Roh00t/SDTH-Killswitch-Demo/video/KILLSWITCH_30s_promotional_pitch.md

# KILLSWITCH — 30-Second Promotional Pitch

> **Final render, submitted 27 September 2026:**
> [`video-demo/killswitch_product_video.mp4`](../video-demo/killswitch_product_video.mp4)
> (42 s, 1280×720). Built from `manim_code.py` and `SDTH_Video.ipynb` in this folder. This
> file is the original brief.

**Format:** Manim motion graphics + AI-generated cinematic footage  
**Tone:** Premium defence-tech launch film; urgent, precise, credible  
**Visual language:** Dark navy/black, cream-white typography, cherry-red threat and engagement graphics  
**Core message:** Air defence should operate as one coordinated network.

It should not look like a slides deck, but like a premium motion graphics video.

---

## Scene 1 - Hook

### Visual

'Killswitch' written out in a serif italic font in the center of the screen in cherry red
A subtitle follows: "Low energy mobile laser air defence network" in cream beige

---

## Scene 2

### Visual
Transition to a stylised top-down city map outline of singapore all generated proceduraly in manim. the city should be borderline must be drawn out.

show a swarm of drones with a red dot flying from the southern coast into city centre following a straight path.
simultaneously show how the count decreases as the drone gets to the city by laser defense nodes located along the coast of singapore. 

Next move it to the side and list out the following bullet points:
- cost effective: <$3 / drone threat
- highly mobile
- virtually infinite magazine

---

## Scene 3

### Visual
AI video demo visualisation. the video is saved as an mp4 file. integrate the video into the manim animation using opencv2 method. 
---

## Scene 4

draw a scale with drone air defense on the left and missile interceptors at the right. then highlight a region in the middle and write laser. then go over the benefits of lasers over drone and missile defense:

**Laser**
- cost effective: <$3 / drone threat
- highly mobile
- virtually infinite magazine
- precise targeting
- rapid engagement

---

## Scene 5
a demo video is saved as an mp4 file. integrate the video into the manim animation using opencv2 method. 

---

## Scene 6
Cut to black.

Same killswitch logo as the first scene.

### Voiceover
> **“KILLSWITCH. One network. Human in command.”**

### Final screen
# **KILLSWITCH**

**ONE NETWORK. HUMAN IN COMMAND.**

*Networked command and control for distributed air defence.*

---

## Production Direction

The video should **not feel like seven PowerPoint slides squeezed into 30 seconds**. Treat it as one continuous visual story. Use Manim for typography, maps, tracks, network topology and UI transitions; use AI-generated footage only for the high-impact physical shots of the drone threat, Singapore environment and mobile directed-energy nodes.

Keep cuts fast during the opening problem, then slow slightly during the KILLSWITCH reveal so the product name lands. The strongest visual sequence should be **Detect → Track → Decide → Authorise → Engage**, because it communicates what the product actually does without requiring a technical explanation.

Avoid trying to explain the underlying laser physics, market size or detailed specifications in this film. The objective of these 30 seconds is to make the judges immediately understand and remember **KILLSWITCH as the coordination layer that turns distributed air-defence assets into a single human-supervised network**.
