Roh00t/SDTH-Killswitch-Demo/report/Killswitch_Report.docx

K I L L S W I T C H

Software-Defined Directed Energy (SDDE)

Reversing the economic death spiral of modern air defence.

Team 49, Killswitch

Singapore Defence Tech Hackathon 2026

Operational Classification: Counter-UAS Targeting & Fire-Control Layer

Primary Track: B, Autonomous Systems & Edge AI (Host Inference, Edge Actuation)

LOTR With Sentinal

1. Executive Summary

Killswitch is an open-architecture, human-in-the-loop targeting and fire-control layer designed to defeat low-cost unmanned aerial systems (UAS) threatening critical urban and sovereign infrastructure. The platform pairs host-based computer-vision inference with edge-microcontroller actuation, enforcing deterministic safety boundaries in firmware to eliminate unauthorised or out-of-envelope directed-energy release.

- Operational challenge: Mass drone swarms break the economics of conventional air defence (~$1M kinetic interceptors against ~$1,000 targets) while creating catastrophic debris hazards over dense populations and petrochemical facilities.
- The Killswitch solution: A distributed, software-defined targeting layer that automates optical acquisition, tracking and aimpoint maintenance, and requires exactly one operator decision to authorise firing, one operator supervising many turrets (1:x), a concept shown with one physical node and simulated map markers.
- Strategic impact (hardened baseline): Verified deterministic fail-safes, a 254 ms deadman cutoff and a 2002 ms maximum burn ceiling, enforced in microcontroller firmware. The system achieves 1.2 px tracking error against static targets and 3–6 px against linear crossing targets.
- Concept economics (from our thermal model): A low-power (~5 kW) commercial laser reaches melt onset on a small UAV at ~1.11 s at 350 m in our own thermal model (tools/thermal_sim.py), at an energy cost of cents of electricity per engagement.it preserves finite kinetic interceptors for the threats that require them. Melt onset is not a structural kill.

# 2. Problem Statement & Operational Context

## The Threat Vignette

Twelve launch sites release roughly 100 fibre-optic drones from a container yard in international waters. Carrying no RF link to detect or jam, and a small radar cross-section, they converge on Jurong Island, Changi and the data-centre corridor. There is no single vessel to sink and no one system to intercept, the threat is everywhere at once, warning is measured in minutes, and if the primary drone defence fails, other options must already be in place.

## Why Conventional Air Defence Fails Here

- Cost & magazine depth: Kinetic interceptors deplete rapidly against saturation salvos (a 20-drone swarm at ~$1k each versus $1M-plus per interceptor), leaving high-value assets exposed during protracted engagements.
- Collateral hazards: Kinetic intercepts over dense urban areas or petrochemical facilities such as Jurong Island present unacceptable explosion and shrapnel risk.
- Manpower ceiling: Fifty kilometres of depth and minutes of warning, with too few soldiers to place one operator behind every weapon, the system needs a scalable decision layer, not more people.
- Accountability: When a machine fires, legal responsibility must rest with a human. Machine-speed defence with a human in the loop is a necessity, not a feature.

The economic asymmetry, at a glance:

| Kinetic Missile | Attacker's Drones | KILLSWITCH Laser Node
Range | long, > 50 km | 10–20 km+ (fibre-optic) | ~350 m (modelled)
Speed | > 100 km/h | slow | speed of light
Magazine | low, finite | high, cheap | unlimited (energy-bound)
Exchange | 1 : 1 | — | 1 : many

## Strategic Weather Imposition

Rather than treat tropical rain as a fatal limitation, an operating doctrine (concept, untested) turns it into an imposed asymmetry: an active directed-energy shield in clear and moderate weather forces an adversary to launch only during heavy monsoons, where degraded battery efficiency, blinded optical-flow sensors, disrupted RF links and wind shear make small UAS fight the environment before they reach the objective. This is an untested operating concept; Singapore’s humidity and haze degrade the beam even without rain.

# 3. Solution Architecture & Technical Innovation

Architecture principle: Host Inference, Edge Actuation. Deep-learning inference runs on a host laptop; real-time motion control and hardware interlocks execute at the edge on an ESP32-S3, which is the safety authority whose interlocks the host cannot override.

## Signal Chain

- ① Sensor: OV5640 Wi-Fi camera, 640×480 (VGA) MJPG stream; OV5640 capture time NOT MEASURED (an earlier USB-webcam bench measured ~32 ms), plus a 100–200 ms network hop.
- ② Host, Vision & Tracking: YOLO11s ONNX inference (1024×1024), latency-compensated aimpoint calculation (<3 ms), serial TX (CH343 @ 921600 baud, XOR checksum).
- ③ Edge, ESP32-S3 (N16R8): Hardware interlocks (254 ms deadman / 2002 ms burn ceiling), open-loop pan/tilt servo PWM @ 50 Hz (the loop closes visually on the host, ~4.6 fps), effector proxy (KY-008 low-power visible laser, ~5 mW Class 3R, low-side switch).
- ④ Operator & C4I: Mandatory SPACE authorisation window (10 s); outbound CoT XML over UDP multicast to ATAK-Civ.

## Engagement State Machine

- 1. SCAN, Calibrated step-and-stare search (20° steps, 0.5 s settle, 2 looks per stop).
- 2. DETECT, YOLO registers a target label; unrecognised or drifted labels are dropped at the input stage.
- 3. TRACK, Pan/tilt slews to align boresight; the control law steps only on new frame_id updates to eliminate stale-observation windup.
- 4. HOLD, Target held within a 15 px (~1.5°) band for 3.0 continuous seconds.
- 5. OPERATOR_AUTH, Armed pause with a 10 s countdown; the operator presses SPACE to authorise or D to deny.
- 6. ENGAGE, Effector fires for exactly 1.8 s (inside the 2002 ms firmware ceiling), then auto-shuts and returns to IDLE.

# 4. Technical Validation & Engineering Hardening

## Evidentiary Discipline

Every figure below carries an explicit evidentiary tag: MEASURED (observed on the rig or in the simulation suite), DERIVED (computed from measured stages), DESIGN (architectural limit), ESTIMATE, and NOT MEASURED. Detection accuracy is deliberately withheld rather than asserted from an unverified run.

Quantitative Performance Matrix

Subsystem / Metric | Value | Status | Source / Verification
Optical Capture (USB webcam, superseded) | ~32 ms (16.7 ms exposure + 15 ms driver) | MEASURED | Earlier USB-webcam bench, not the current OV5640
YOLO11s Inference (1024×1024) | 216 ms/frame (4.6 fps) | MEASURED | macOS CPU, best.onnx (demo runs COCO on Windows)
Track + Aimpoint Calculation | < 3 ms | ESTIMATE | Architectural timing limit
Serial TX + ESP32 Parsing | ~3 ms (921600 baud) | ESTIMATE | Serial protocol calculation
Total Latency (Direct USB) | ≈ 254 ms | DERIVED | Sum over the superseded USB-webcam path
Wi-Fi Camera Network Hop | +100 to 200 ms | ESTIMATE | Network transit estimate
Total Sensor-to-Effector Latency | ≈ 414–514 ms (incl. 60 ms servo slew) | DERIVED | Full-pipeline baseline over Wi-Fi
Tracking Error (Static Target) | 1.2 px | MEASURED | Closed-loop simulation (1280 px, not the 640 px rig)
Tracking Error (Crossing Target) | 3–6 px (at 5°–20°/s) | MEASURED | Closed-loop simulation (1280 px, not the 640 px rig)
Dynamic Tracking Limit | Fails at ±15° weave @ 0.2 Hz (21.7 px) | MEASURED | Closed-loop sim · loop-bandwidth limit, 4.6 fps
HOLD Alignment Band | 15 px ≈ 1.5° (~8 cm at 3 m) | DERIVED | Optical geometry (FOV uncalibrated, see bench.yaml)
Hardware Deadman Timeout | 254 ms (250 ms design) | MEASURED | Firmware timer, physical ESP32 (v2 bench; re-verify on v3)
Hardware Burn Cutoff | 2002 ms (2000 ms design) | MEASURED | Firmware timer, physical ESP32 (v2 bench; re-verify on v3)
Firmware Application Size | 1,049,558 / 3,145,728 B (33.4%) | MEASURED | Build output report
Software Test Suite | 337 tests passing | MEASURED | pytest tests/ -q (offline)
Hardware Interlock Suite | 13 / 13 passed | MEASURED | Physical, firmware v3 (interlock state; laser wiring re-verify)
Detection Precision / Recall / mAP | Pending held-out evaluation | NOT MEASURED | Explicitly withheld from claims

Note: Tracking-error figures (static, crossing, dynamic limit) are from the closed-loop simulation suite, not physical live-fire; the Source column states this for each. Deadman and burn-ceiling timings were measured on the physical ESP32 with firmware v2 on the old pins; re-verification on v3 with the laser correctly wired is pending. The 720p / 32 ms optical figure is from a superseded USB webcam, the current OV5640 streams VGA and its capture time is not yet measured.

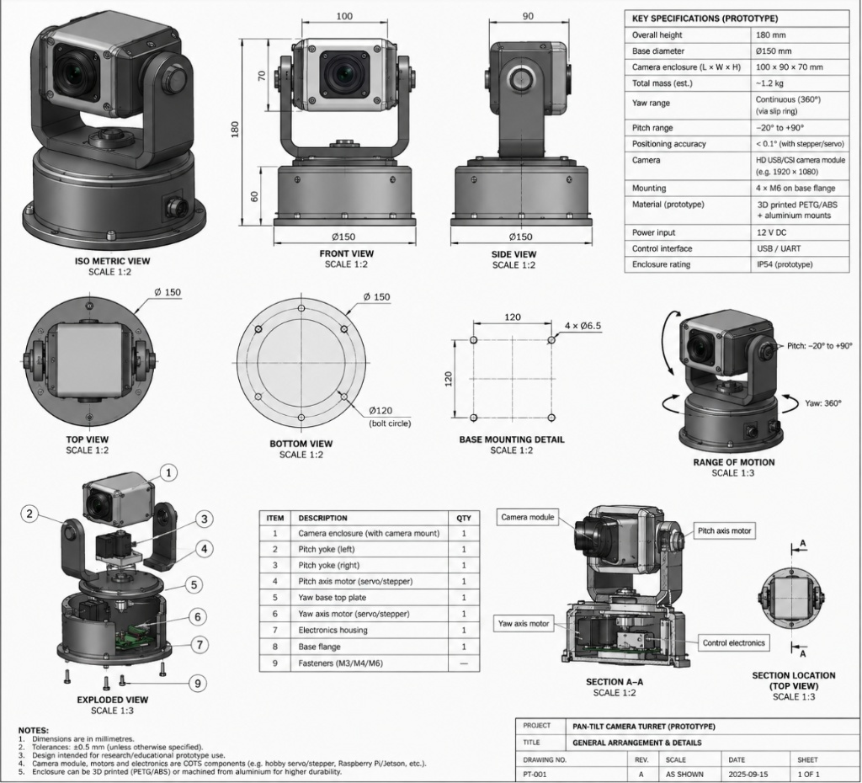
[picture p2: figure]

Figure 1: Concept render of the Phase-2 production turret (concept only, no CAD files yet). The benchtop demonstrator validates the closed-loop control mathematics on a COTS 2-axis mount; this baseline specifies the hardened mechanical path, NEMA 17 steppers, continuous 360° slip ring, and an integrated sealed optical compartment (IP54).

## Real Sprint Hurdles Overcome

- 1. Frame-rate bottleneck (4.6 fps on CPU), At 4.6 fps, weaves above 0.1 Hz broke the 15 px HOLD band, a loop-bandwidth limit set by the 4.6 fps observation rate that no smoothing could overcome. Documented as a sampling constraint; Phase 2 migrates to GPU/NPU or 640 px re-exports for ≥15 fps.
- 2. Stale-observation windup, The 100 Hz control loop re-applied identical pixel errors ~20× per visual frame, saturating actuator commands. Hardened main.py to step strictly on an incremented frame_id.
- 3. Scan-sweep image smear, Continuous scanning at 400°/s blurred frames and prevented inference locks. Replaced with step-and-stare (20° steps, 0.5 s settle, 2 looks).
- 4. Hardware pin collision (GPIO 7), On the ESP32-S3-EYE layout, GPIO 7 carries the camera HREF signal, wiring the laser gate there pulsed the effector at line rate. Relocated actuator pins to Pan 14 / Tilt 21 / Laser 1, with static_assert compile-time overlap checks.
- 5. Wi-Fi camera pipeline recovery, The OV5640 stalled indefinitely on dropped frames. Firmware resets the camera bus after 3.0 s of frame silence; the host reader auto-reconnects.
- 6. Input / serialisation hazards, Non-finite floats (Infinity, NaN) from a neutralised threat’s infinite time-to-impact froze the dashboard. All outbound telemetry now passes a strict dashboard_json sanitiser; stale operator authorisations are discarded when the authorisation window opens.

# 5. Military Integration & Strategic Scaling

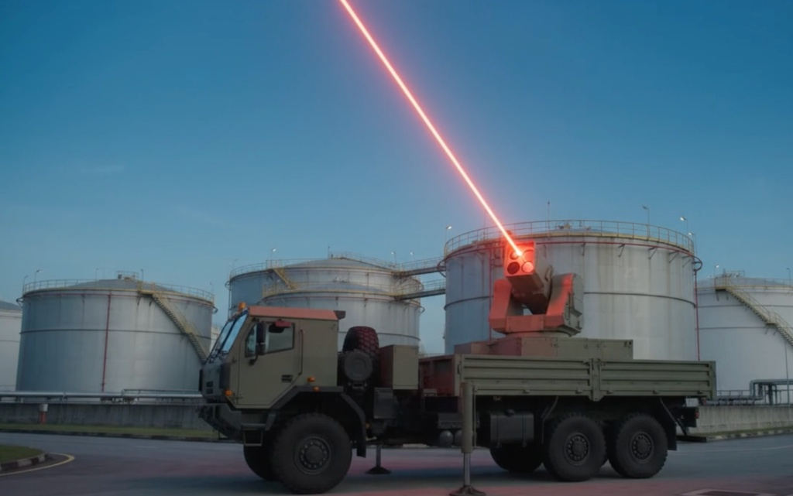
[picture p3: figure]

Figure 2: Operational deployment concept for mobile infrastructure point-defence. Killswitch targeting nodes on tactical transport platforms provide mobile, low-collateral defensive screens for high-value petrochemical and military installations.

## Track A, Input Integrity & Effector Isolation

Killswitch is built on an effector-isolation model. The prototype MQTT transport is plaintext on port 1883 with a shared token; the architecture isolates the effector regardless:

- Zero unauthenticated control: external WebSockets and network feeds have no direct write path to the actuator; commands originate only from the host engine loop.
- Track-locked authorisation: a token issued for Track A cannot execute if the system switches to Track B.
- Fail-safe parsing: malformed frames, out-of-range values or checksum mismatches drive the laser output LOW and return an error state.
- Hardware isolation window: on host OS freeze, kernel panic or disconnection, the ESP32 deadman cuts laser power within 254 ms.

## Track C, C4I & Tactical Decision Support (ATAK-Civ)

- Operator cognitive management: exactly one human decision per engagement, the operator evaluates track context, confirms the backstop is clear, and presses SPACE; they never aim or slew the system.
- Map honesty: outbound CoT feeds to ATAK-Civ mark simulated swarm entities with a SIMULATED tag; only Node 1 reports physical telemetry, preventing a false operational picture during hybrid exercises.
- Tasking independence: operator keys 1–3 append tasking metadata to simulated tracks only; they hold no authority to command or fire a physical effector.

# 6. Lifecycle Roadmap & Phase-2 Maturation

Domain | Milestones & Engineering Deliverables
Host Inference | Port the model to a dedicated GPU/NPU (≥15 fps target); formal evaluation on a held-out dataset for empirically verified mAP50, precision and recall.
Physical Actuation | Replace hobby servos with brushless motors and optical absolute encoders; add integrated hardware timestamps to measure and compensate for Wi-Fi transit jitter.
Cyber Hardening | Migrate MQTT to mTLS 1.3 (port 8883); HMAC-SHA256 serial-frame validation; ESP32-S3 Secure Boot v2 and Flash Encryption.
Operational Safety | CAAS-compliant live-fly testing with a certified Range Safety Officer; transition from the proxy diode to a rated effector behind identical firmware safety gates.

Killswitch delivers a sovereign, mathematically grounded targeting layer that restores defensive cost dominance in dense urban theatres, an auditable, scalable C-UAS fire-control solution with a human always in the loop.

THE ASK

We proved the mathematics that don't change with scale. Incubation unlocks the conditions a lab cannot create.

What we proved, on ~$200 of COTS hardware

- The full loop in simulation: detect → track → predict → hold → authorise → engage. On hardware, actuation and firmware interlocks are verified; live detection is pending.
- Firmware-enforced safety, measured on the physical board (firmware v2 bench; re-verification on v3 pending): 254 ms deadman cutoff, 2002 ms burn ceiling. The human gate is a state in the transition table, not a callback anyone can forget.
- Sub-degree tracking in simulation (1280 px, not the rig): 1.2 px against static targets, 3–6 px against crossing targets.
- 337 automated tests passing; 13/13 firmware-interlock checks (interlock state proven; laser wiring re-verify).
- We report only what we measured, detection accuracy is withheld, not inflated.

What only you can unlock, beyond any lab or hackathon

- Live-fly range time with a Range Safety Officer, CAAS-compliant testing against real airborne targets, not simulation.
- A rated effector behind our identical firmware safety gates. We fire a low-power visible laser proxy (<5 mW, Class 3R) today; the firmware safety logic is designed for a hazardous emitter, a fielded HEL also needs beam-path interlocks and key control we have not built.
- Harsh-condition validation, tropical humidity, haze, monsoon rain and thermal blooming: the exact envelope our weather doctrine rests on, that no bench reproduces.
- Threat-representative targets, fibre-optic and fixed-wing drones we cannot legally acquire or fly on our own.
- A compute path to ≥15 fps (GPU/NPU) to clear the 4.6 fps sampling bottleneck we have already documented.

What you get

For the incubator (NUS Defence Venture Lab and programme partners)

- A dual-use, software-defined venture with a defensible wedge, the portable targeting brain, not another turret.
- A working prototype and honest metrics already in hand, from a team that demonstrably ships.
- A sovereign-capability story aligned to your national mandate, and a stake in a layer that re-hosts across many effectors.

For the defence stakeholder (MINDEF · DSTA · RSAF)

- A cost-exchange fix you own, not one you license from a foreign prime.
- Sovereign, auditable, human-gated software: every engagement logged, no black box.
- Hardware-agnostic, it augments existing kinetic and future directed-energy assets, protecting prior investment.
- A low-risk way to evaluate the 1:x operator-ratio concept before committing to a programme of record.

ONE NETWORK. MULTIPLE NODES. HUMAN CONTROL.

KILLSWITCH · Team 49 · SDTH 2026 Page 1 of 2
