Roh00t/SDTH-Killswitch-Demo/Pitch_Deck_KILLSWITCH.pdf

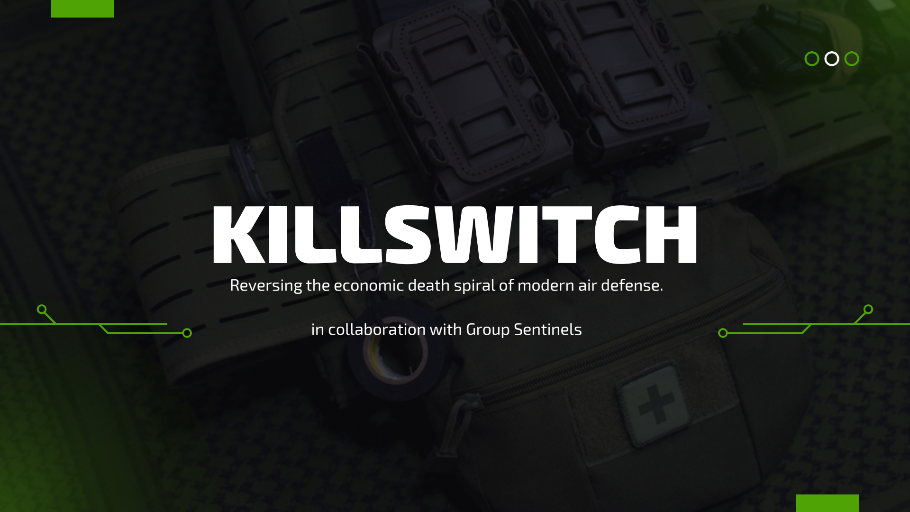
[picture p4: page 1]

KReve

I

rsinLg the eLconomSic deaWth spiral of

I

modTern airCdefenHse.

in collaboration with Group Sentinels

## SCENARIO

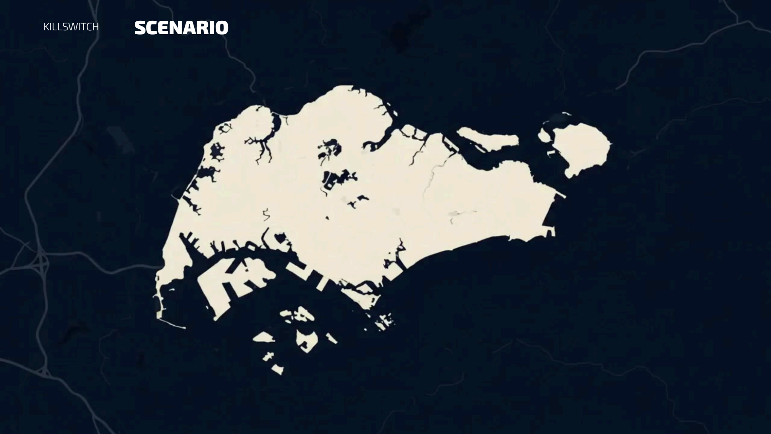
[picture p5: page 2]

KILLSWITCH

# AIR DEFENSE TODAY

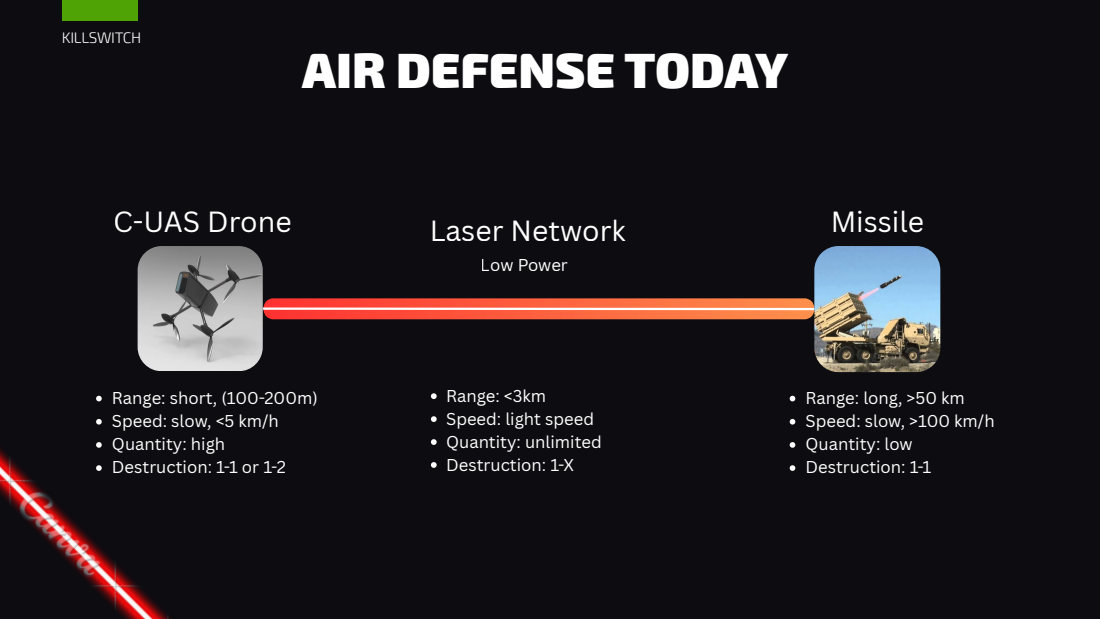
[picture p6: page 3]
Range: short, (100-200m) Speed: slow,; <5 km/h Quantity: high Destruction: 1-1 or 1-2; C-UAS Drone; Missile; Range: long,; Speed: slow,; >100 km/h Quantity: low Destruction: 1-1; Laser Network; Low Power

Range: <3km
Speed: light speed
Quantity: unlimited
Destruction: 1-X

# THE PROBLEM

1.The Cost Disparity: Defense forces are firing $3,000,000 kinetic interceptors to shoot down $2,000 commercial fiber-optic drones.

Modern militaries are bankrupting themselves to defend against cheap technology.

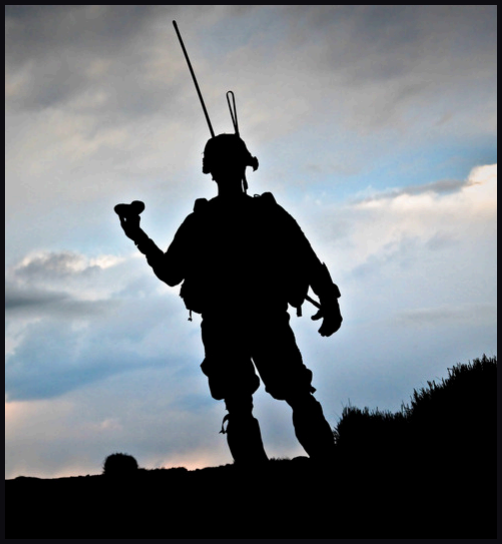
[picture p7: figure]

3.The Magazine Depth Flaw: Swarms do not present a single point of failure. Current air defense systems rely on a finite number of missile tubes; once the magazine is empty, the airspace is completely defenseless.

2.The Human Bottleneck: Traditional systems require a 1:1 operator-to-weapon ratio. When facing a 40-drone swarm, a 1:1 human decision cycle is mathematically too slow to prevent perimeter breaches.

# THE SOLUTION

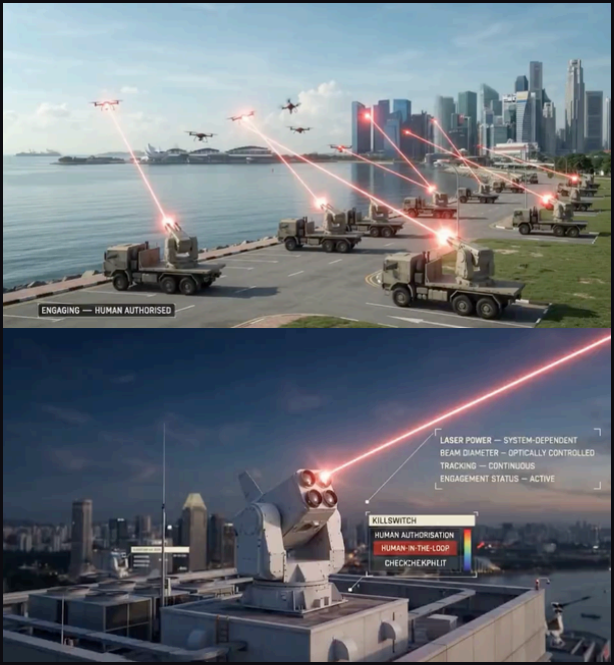
[picture p8: figure]

1.Imbalance Over Vaporization: Legacy military lasers (50kW+) require massive diesel generators just to melt metal.

KILLSWITCH utilizes low-cost, low-power (5kW) commercial lasers to apply steady thermal load to aerodynamic weak points (rotors, polymer struts). At high RPMs, a mere 5% structural deformation causes catastrophic aerodynamic imbalance, tearing the drone apart in mid-air.

2. 1:10 Decision Layer: Partnering with Team Sentinels, our software architecture eliminates the 1:1 manpower bottleneck, allowing a handful of operators to run the entire grid.

3.Human-in-the-Loop (HITL): The network automatically detects, tracks, and assigns the optimal overlapping lasers to the target. The machine handles the micro-millimeter tracking; the human operator retains ultimate firing authority, strictly satisfying military Rules of Engagement (ROE).

# SIMULATION

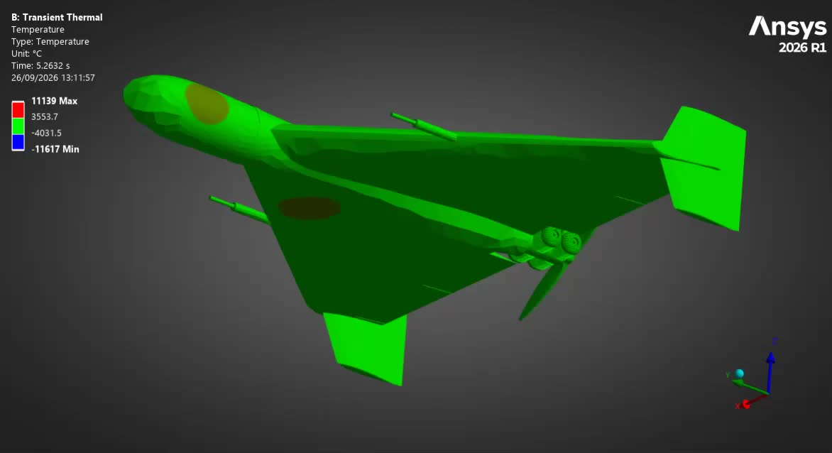
[picture p9: figure]

### COST EFFECTIVENESS:

Works alongside kinetic
interceptors
5 KW turrets thermally degrades a singular small UAV in 1.7s

<$1 / node : <$3 to take down a drone

Threat: 100 simulated Shahed-class microdrones inbound at 50 m/s (180 km/h).
Convergence Math: 1 Laser = Baseline TTK. 2 Lasers = 50% TTK. 4 Lasers = Instant structural failure.
Result: Multi-node simultaneous engagement clears the swarm before perimeter breach.

# HOW IT WORKS

A self-scaling, distributed defensive web that multiplies lethality through overlapping sectors.

Imbalance Kill: Thermal load warps the composite propeller. At high RPMs, the aerodynamic

Detect: LiDAR acquires the target at a 3 km range.

Classify: Edge AI identifies the drone type and maps its specific structural weak points (e

Deconflict: The AI algorithm calculates safe firing trajectories to ensure zero collateral

Converge: Multiple networked lasers are assigned to overlap on the exac

# Add a subheading

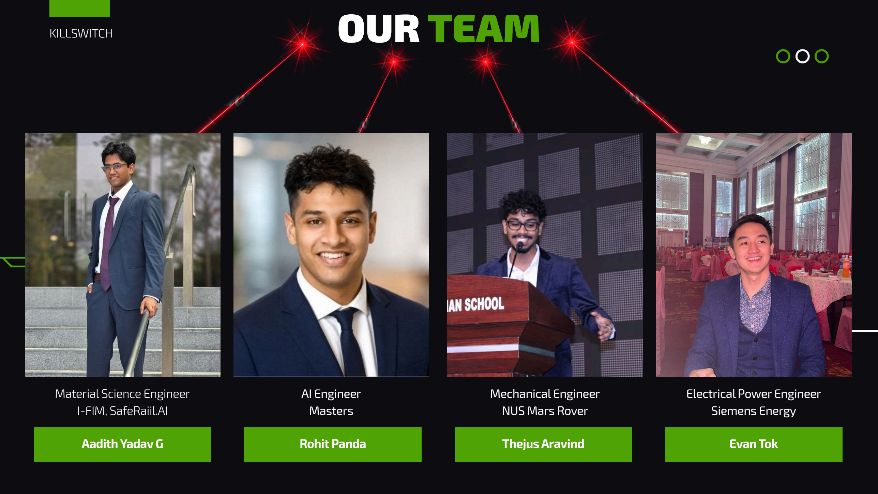
[picture p10: page 8]

AadithYadavG | Rohit Panda | ThejusAravind | Evan Tok
KILLSWITCH | OUR TEAM

Material Science Engineer
I-FIM, SafeRaiil.AI

AI Engineer
Masters

Mechanical Engineer
NUS Mars Rover

Electrical Power Engineer
Siemens Energy
