Roh00t/SDTH-Killswitch-Demo/video/aadith.jpg

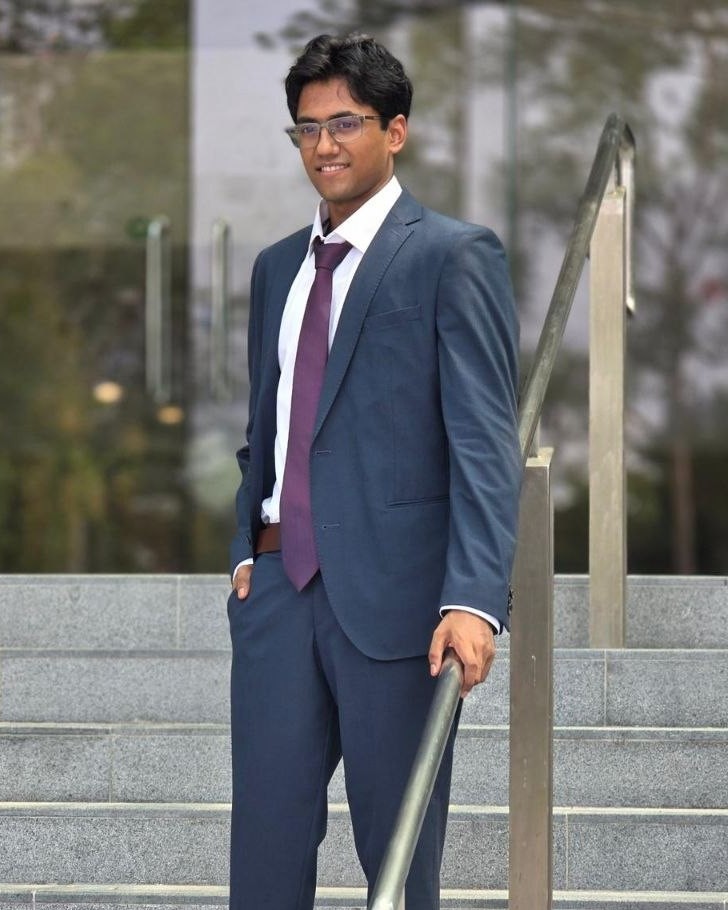
video/aadith.jpg
