Roh00t/SDTH-Killswitch-Demo/video/evan.jpg

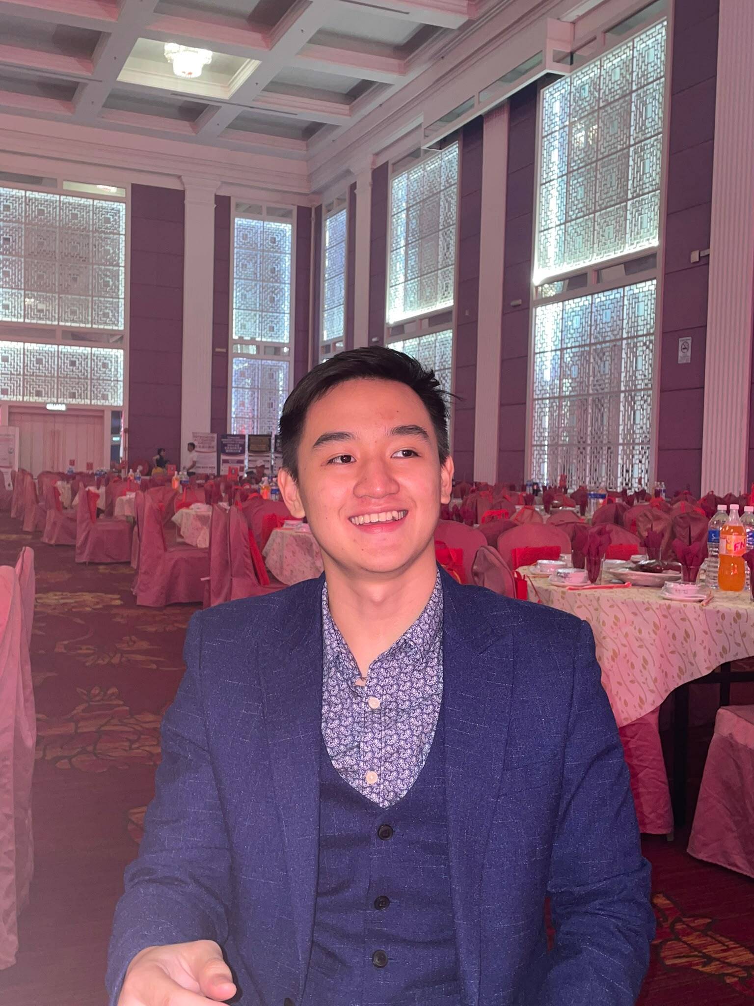
video/evan.jpg
