Roh00t/SDTH-Killswitch-Demo/video/rohit.jpg

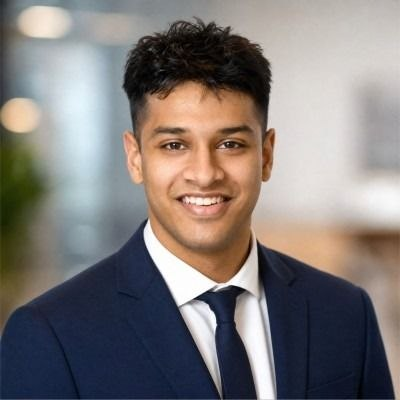
video/rohit.jpg
