Roh00t/SDTH-Killswitch-Demo/video/thejus.jpg

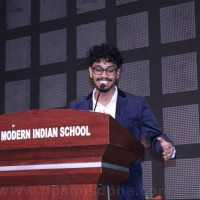
video/thejus.jpg
