Roh00t/SDTH-Killswitch-Demo/config/bench.yaml

# Killswitch — benchtop node configuration.
# Every tunable lives here. No magic numbers in code (CLAUDE.md coding standards).

node:
  id: "killswitch-01"
  tick_hz: 100          # State machine tick. Fast: it enforces every fail-safe.

camera:
  device_index: 0
  width: 1280
  height: 720
  target_fps: 60
  use_mjpg: true
  # Horizontal field of view, degrees. CALIBRATE THIS: point at a known angular
  # span and measure. It sets the pixel-to-degree gain for the whole control
  # loop, so an error here shows up as sluggish or oscillatory tracking.
  horizontal_fov_deg: 65.0
  # ESP32-S3 Wi-Fi camera. When set, it is used INSTEAD of device_index.
  # The firmware prints it on COM3 once Wi-Fi is up ("CAM http://.../stream"),
  # and main.py logs it. null = use the USB camera at device_index.
  # With the OV5640, re-measure horizontal_fov_deg above for that lens.
  stream_url: "http://10.244.153.41/stream"
  # If the gimbal turns AWAY from the target, flip that axis (stream only):
  # pan wrong -> flip_horizontal, tilt wrong -> flip_vertical.
  flip_horizontal: false
  flip_vertical: false

detector:
  weights: "model/best.onnx"
  conf_threshold: 0.40
  iou_threshold: 0.50
  # MUST match the export. best.onnx is a FIXED-SHAPE export at 1024x1024
  # (dynamic=False), so Ultralytics silently ignores any other value. Setting
  # 640 here does not make it run at 640 — it makes the config a lie.
  # Verified: onnxruntime reports input "images" shape [1, 3, 1024, 1024].
  imgsz: 1024
  # Model class map, read from ONNX metadata:
  #   {0: drone, 1: bird, 2: airplane, 3: helicopter}
  # bird/airplane/helicopter are the confuser classes — trained as negatives,
  # never engaged. Filtering is by NAME, so index drift cannot silently
  # re-target us; an unknown name is rejected at construction.
  target_classes: ["drone"]
  device: null          # null = let ultralytics choose (cuda > mps > cpu)

targeting:
  # Normalised offset within the detected box.
  #   ( 0.00,  0.00) centre of mass
  #   (-0.35, -0.35) forward rotor hub
  #   ( 0.00,  0.40) slung payload
  offset_x: 0.0
  offset_y: 0.0
  # Below this box dimension the offset is inside box jitter, so the solver
  # reverts to centre-of-mass and says so.
  min_box_px: 40.0

control:
  proportional_gain: 0.6     # Under-damped above ~1.0 on SG90s.
  max_step_deg: 6.0          # Per tick, per axis. Firmware also rate-limits.
  deadband_px: 3.0           # Below this, do not command — SG90s just buzz.

prediction:
  smoothing: 0.4
  max_lead_px: 250.0
  # Seed only; replaced by live measurement within a few frames.
  initial_compute_latency_s: 0.060
  # Servo travel allowance. NOT measurable — SG90s have no position feedback.
  # Estimated, and labelled as estimated wherever it surfaces.
  mechanical_allowance_s: 0.060

engagement:
  hold_error_px: 15.0        # Error band for HOLD.
  hold_duration_s: 3.0       # Continuous. Resets on any excursion.
  track_loss_timeout_s: 1.0  # No target for this long -> back to SCAN.
  scan_timeout_s: 30.0       # No detection for this long -> IDLE.
  auth_timeout_s: 10.0       # No operator decision -> back to TRACK.
  # 1.8, NOT 2.0. The firmware ceiling is MAX_BURN_MS = 2000 and its clock
  # starts when it parses L1, before the host's does — at 2.0 the firmware wins
  # every nominal burn and logs a clean engagement as an "E06 burn ceiling"
  # safety trip. 200 ms of margin gives nominal completion back to the host.
  burn_duration_s: 1.8

scan:
  # One stop per step: with a ~65 deg camera, 20 deg steps overlap each view
  # by about two thirds. 4 deg made sense only while the sweep never stopped.
  pan_step_deg: 20.0
  tilt_step_deg: 20.0
  # Step-and-stare. After each move the gimbal holds still until this many
  # frames, captured at least settle_s after the move, have been through the
  # detector. settle_s covers servo travel plus the Wi-Fi camera's delay
  # (~100-200 ms); a frame sooner than that can show the old view or smear.
  settle_s: 0.5
  looks_per_stop: 2
  max_cycles: 2
  # Azimuth the gimbal faces at pan centre. Cues outside +/-70 of this are
  # rejected, not clamped.
  boresight_azimuth_deg: 0.0

actuator:
  # "auto" finds the USB-UART bridge by description. macOS hands out
  # /dev/cu.usbserial-<n> where <n> changes between plugs, so hardcoding it
  # guarantees a failure at the worst possible moment. Override with an
  # explicit path only if two boards are attached.
  port: "auto"
  baud: 921600
  # Link bring-up budget. Opening the port asserts DTR, which RESETS the ESP32;
  # both waits below happen on every connect, so the real budget is their sum.
  #
  # The ESP32-S3-N16R8 boots slower than the WROOM-1 these were first tuned on
  # (8 MB PSRAM init), and the old 2.0 + 3.0 sat close enough to its real boot
  # time that connect() succeeded or failed by luck. If you still see
  # "No status from firmware ... within", raise connect_timeout_s — never
  # suppress the DTR reset. The reset is what makes "connected" mean "known
  # state", and it is what emits the boot banner reporting PWM attach failures.
  boot_settle_s: 2.0
  connect_timeout_s: 6.0
  stow_pan_deg: 90.0
  stow_tilt_deg: 90.0
  # The rig's pan SG90 turns ANTICLOCKWISE (seen from above) as its angle rises;
  # the cue geometry, the dashboard radar and the control law all mean
  # CLOCKWISE. true mirrors pan in the serial driver, both ways, so the laptop
  # fixes it and the firmware is untouched. serial_probe reads this key too.
  # After changing it, redo the target tape mark: pan 45 points the other way.
  pan_reversed: true

c2:
  broker_host: "localhost"
  broker_port: 1883
  # Shared secret on operator auth. null disables token checking, which is
  # acceptable ONLY on an isolated demo network and must be stated as such.
  auth_token: "sdth-demo-token"

# Annotated video link to tools/operator_console.py. The node owns the camera,
# so the console cannot open it — two processes cannot share a USB device.
video:
  enabled: true
  fps: 15
  max_width: 640
  quality: 60
