Roh00t/SDTH-Killswitch-Demo/firmware/esp32_actuator/wifi_secrets.example.h

// Copy this file to wifi_secrets.h in the same folder and fill it in.
// wifi_secrets.h is gitignored: never commit a real password.
//
// Use the network the laptop is on (e.g. the phone hotspot). The ESP32-S3 only
// does 2.4 GHz: on an iPhone hotspot turn on "Maximise Compatibility".
#pragma once
#define WIFI_SSID     "your-hotspot-name"
#define WIFI_PASSWORD "your-hotspot-password"
