Roh00t/SDTH-Killswitch-Demo/(commit log)

2026-09-20 Step B (ESP32 firmware + SerialActuator + MQTT)
2026-09-20 The model runs on your laptop, the laptop computes the aim angles, and the ESP32 drives the two servos toward the target
2026-09-23 Thermal Kill-Chain Simulation
2026-09-23 INFO: Effective Spot Radius at 350.0m: 43.00 cm INFO: Surface Heat Flux: 1.11 W/cm^2 INFO: Plot safely written to /Users/rohitpanda/Documents/GitHub/SDTH-Killswitch-Demo/docs/thermal_kill_chain.png
2026-09-23 INFO: Effective Spot Radius at 350.0m: 13.78 cm INFO: Surface Heat Flux: 10.77 W/cm^2 INFO: Time to Onset of Melting (Tmelt = 260.0°C): 1.106 s INFO: Plot safely written to /Users/rohitpanda/Document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
    [thermal_sim.py]
2026-09-23 **Simulation Parameters:** * **Optical Load:** 5 kW at 1.55 µm (Atmospheric Attenuation: $\gamma = 0.0008$) * **Engagement Range:** 350 meters * **Boresight Jitter:** 0.282° (4.9 mrad) * **Target Mat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
2026-09-25 Support ESP32-S3-N16R8 + CH343 on Windows; fix bridge event loop
    HITL testing on Windows/Python 3.14 surfaced two blocking defects and a
    hardware change that the docs no longer described.
    tools/c2_bridge.py — the bridge died at startup with NotImplementedError.
    aiomqtt drives paho through loop.add_reader(), which ProactorEventLoop (the
    Windows default since 3.8) does not implement. _run_bridge() forces a selector
    loop on win32. It uses asyncio.run(loop_factory=...) on 3.12+ rather than
    set_event_loop_policy, which 3.14 deprecates with removal targeted for 3.16;
    the policy call remains only for 3.11, the one version with TaskGroup but
    without loop_factory. Scoped to main() rather than modu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
    [actuator.py, c2_bridge.py, esp32_actuator.ino, fallback.yaml]
2026-09-25 Align burn ceiling across all configs; log HITL actuator verification
    bench.yaml and smoketest.yaml carried burn_duration_s: 2.0, matching the
    firmware's MAX_BURN_MS exactly. The firmware starts its clock when it parses L1,
    before the host starts its own, so at 2.0 it wins every nominal burn and reports
    a clean engagement as an "E06 burn ceiling" safety trip. All three profiles are
    now 1.8, which is what fallback.yaml already used.
    Documented the Windows HITL result as what it actually covers: the actuator
    path. The serial link, status framing and absolute positioning are verified.
    Two gaps are recorded rather than glossed:
    - The travel corners are untested. --servo-sweep commands pan 5/17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
    [bench.yaml, smoketest.yaml]
2026-09-25 Record actuator path HITL complete: serial_probe 13/13 on COM3
    Every firmware interlock is now exercised on the rig: boot state, bounds
    clamping, the arming interlock, effector energise and de-energise, the burn
    ceiling, and the deadman cutting both the effector and arming. That closes the
    two gaps the previous status recorded — the travel corners and the untested
    effector path.
    Kept one distinction the pass count hides. The two bounds checks read pan/tilt
    out of the status frame, and those are commanded angles, not measured ones —
    run_checks() says so itself, noting its gimbal section passes even with no
    servos attached. 13/13 proves the firmware clamps correctly; physical travel to
    pa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
2026-09-25 Widen the actuator bring-up budget for the S3-N16R8; keep the DTR reset
    main.py crashed at startup with "No status from firmware on COM3 within 3.0s"
    while serial_probe connected to the same board fine. The reported cause was
    that main.py resets the ESP32 over DTR and serial_probe does not.
    That is not what the code does. Both construct SerialActuator without
    connect_timeout (main.py:221, serial_probe.py:41/143/210), so both take the
    same 3.0s default, and both call the same connect(), which opens the port the
    same way and sleeps the same 2.0s. There is no second code path to bypass the
    reset. Two callers of identical code disagreeing is a marginal budget, not a
    divergence: the S3-N16R8's 8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
    [actuator.py, bench.yaml, fallback.yaml, protocol.py, smoketest.yaml]
2026-09-25 Add --sim-target: run the full demo stack with no hardware
    The existing mocks could not run a demo end to end. --mock also swaps in the
    in-memory MockC2Client, so the bridge, console and dashboard cannot reach the
    node. --mock-detector builds ScriptedDetector([]), which never detects, so the
    node sweeps, exhausts the search at ~7.9 s and returns to IDLE without ever
    reaching OPERATOR_AUTH. MockFrameSource's docstring promised "a configurable
    blob" but read() returns an all-black frame; corrected.
    --sim-target replaces the camera and detector with SceneDetector, which wires
    the closed-loop scene model tools/simulator.py already uses for the
    convergence proof into the live vision worker. Each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
    [simulator.py, test_sim_scene.py]
2026-09-25 Harden CoT for ATAK-CIV phones: unicast, map base, stale pad, honest labels
    A proposed standalone script (atak_1to3_hardened.py) raised real field risks
    but could not ship: select() on stdin crashes on Windows, its IP_MULTICAST_IF
    fix was never implemented, a 180 s stale window would keep neutralised threats
    on the map for three minutes, a keypress could mark a node ENGAGED with no
    authorisation gate, and it drew a second picture that desyncs from
    FleetState. This folds the sound ideas into the existing bridge instead.
    Unicast fallback. --cot-unicast IP[:PORT], repeatable, sends every datagram
    to the listed devices as well as the multicast group. Phone hotspots and many
    access points drop m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
    [c2_bridge.py, cot.py, multicast_test.py, test_cot.py]
2026-09-25 Serve the live C2 dashboard to an iPhone over the LAN
    An iPhone can't be a TAK client for this bridge. ATAK-CIV is Android-only,
    and iTAK doesn't take multicast; it connects to a TAK server over TLS with
    per-device certificates. The dashboard is the practical way to put the live
    picture on an iPhone, and four things stopped it working there.
    The page connected to ws://localhost:8765, which on a phone is the phone. It
    now connects back to whichever host served it, falling back to localhost for
    file://.
    It had no viewport tag and a fixed full-height 2x2 grid, so a phone rendered
    it at desktop scale. Below 760 px the page now scrolls and the panels stack
    in one column. Nothing changes above t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
    [c2_bridge.py, test_cot.py]
2026-09-25 One command per window in the runbook; print only reachable phone URLs
    On the demo laptop, the iPhone dashboard never appeared because the bridge
    never started. http.server and the bridge were pasted into one PowerShell
    window. The >> prompt meant PowerShell had taken both lines as one input;
    http.server blocked in the foreground, the bridge line never ran, and Ctrl+C
    cancelled both. The README invited this: the iPhone steps and the Demo
    Runbook put several long-running commands in one copyable block, and the
    runbook's block used :: comment lines, which are cmd syntax and fail in
    PowerShell. Every block now holds one command under its own Window/Terminal
    heading, with a note on what >> means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
    [multicast_test.py, test_cot.py]
2026-09-25 Show the auth countdown in Panel C; stop showing a dead node's numbers
    Panel C read "12.1 / 3.0 s" through the whole operator decision window.
    The hold timer is not reset when HOLD hands over to OPERATOR_AUTH, and the
    telemetry reported it in every state. The node now reports hold_s only in
    HOLD and adds auth_remaining_s / auth_timeout_s, read together with the state
    through a new StateMachine.snapshot(). A separate read of state and age could
    straddle a force_idle from the vision thread. In OPERATOR_AUTH the dashboard
    cell becomes AUTH WINDOW with a draining bar.
    Panel C's tag claimed "MOCK ACTUATOR" whenever telemetry lacked
    mock_actuator=false, including when there was no telemetry at al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
    [c2_bridge.py, test_cot.py, test_state_machine.py]
2026-09-25 Stop a neutralised threat freezing the dashboard
    A threat that reaches 10 m becomes NEUTRALIZED, and its time_to_impact_s is
    inf. json.dumps writes that as `Infinity`, which JavaScript's JSON.parse
    rejects. The dashboard drops any frame it cannot parse, so from the first
    neutralisation to the scenario reset every frame was dropped. The page froze
    while the header still read CONNECTED: about 26 s of every ~50 s cycle on the
    default scenario, and about 4 s per cycle with --threat-start-m 420.
    Every dashboard frame now goes through dashboard_json(), which nulls
    non-finite floats, including any in node telemetry passed through. The
    dashboard already renders null as a dash and sorts it last. Pre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
    [c2_bridge.py, test_cot.py]
2026-09-25 Safe the actuator after a forced IDLE; drop auths from before the window
    Two paths bypassed the safe harbour.
    force_idle() from the vision thread (detector fault) only moved the state.
    Nothing on that path turned the effector off, and _check_liveness skips IDLE,
    so a fault mid-burn left the effector on until the firmware's 2.0 s burn
    ceiling. The tick thread now notices any IDLE it did not enter itself and runs
    _enter_idle: effector off, disarm, stow, within one tick. The flag it keeps is
    read and written only on the tick thread, so it adds no cross-thread handoff.
    A failed safing attempt is retried once per firmware deadman period instead of
    being abandoned, and each forced safing is writt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
    [test_state_machine.py]
2026-09-25 Stage and Scale sheets; fix the outbound CoT firewall rule
    docs/STAGE_SHEET.md, the physical node:
    - Safety rules read aloud at T-60.
    - A T-60 checklist:
    - power order;
    - COM3 check;
    - taping the target spot with serial_probe --interactive;
    - vision_probe on the real object;
    - offline weights;
    - broker bound to localhost.
    - A config-only tuning table.
    - The start order with the bridge last.
    - A timed execution table with call and response.
    - Recovery, the --sim-target fallback, and a say / don't-say facts table.
    Target movement is allowed only while the pill reads SCAN or TRACK, when the
    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
2026-09-25 camera_probe: say whether the configured camera is reachable
    The probe listed the working indices but never said whether the one the node
    opens (camera.device_index) was among them, and it measured whichever index
    came first, usually the laptop's built-in camera. It now reads --config and
    prints "camera.device_index=N -> FOUND" or "NOT FOUND" with the working
    indices. It also prints how to tell which index is the external camera (unplug
    it and re-run), and then measures the configured camera. The no-camera hint was
    macOS-only; on Windows it now names the privacy switch that blocks desktop apps
    and the apps that hold the camera.
    Stage Sheet: a T-60 camera row, and a rule never to flash a cam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
2026-09-25 Correct the camera pinout claim; keep the camera ribbon off the actuator
    The Stage Sheet said every ESP32-S3 camera pinout uses GPIO 5-7, and
    CLAUDE.md said every common one does. Checked against Espressif's
    CameraWebServer camera_pins.h: the ESP32-S3-EYE, DFRobot and M5Stack S3 layouts
    do, and XIAO and CAM_LCD do not. The EYE layout, used by most N16R8 camera
    boards, puts SIOC on GPIO 5, VSYNC on 6 and HREF on 7, the laser gate.
    The rig's OV5640 is plugged into the actuator board's own camera connector. It
    is unused, and the actuator firmware never enables it, but a camera sketch
    would let HREF drive the laser. The Stage Sheet now has a T-60 step to unplug
    the ribbon, and says why.
    Co-Aut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
2026-09-25 Stream the ESP32-S3's own camera over Wi-Fi; move the actuator off GPIO 5/6/7
    The rig has no USB webcam. Its only camera that turns with the gimbal is the
    OV5640 on the actuator board's camera connector. That connector uses the
    ESP32-S3-EYE layout: SIOC on GPIO 5, VSYNC on 6 and HREF on 7, which were pan,
    tilt and the laser gate.
    Firmware v3:
    - The actuator moves to pan 14, tilt 21, effector 1, with the pulldown moving
    too. static_asserts refuse to build if any actuator pin is a camera pin
    (checked: moving the laser back to GPIO 7 fails the build).
    - KS_CAMERA adds the OV5640 at VGA JPEG with CAMERA_GRAB_LATEST, non-blocking
    Wi-Fi (credentials in a gitignored wifi_secrets.h), an MJPEG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
    [actuator.py, bench.yaml, camera_probe.py, esp32_actuator.ino, fallback.yaml, serial_probe.py]
2026-09-26 Restore firmware v3 and wifi_secrets.example.h on main
    e88483b replaced esp32_actuator.ino with a byte-identical copy of the v2
    file from 6f7eced (pins 5/6/7, no camera), and 2a80030 deleted the example
    secrets header. Every doc, serial_probe and guardrails.md still describe
    v3's pins 14/21/1, so main disagreed with itself, and a pull handed back
    firmware whose effector pin is the camera's HREF line.
    Both files are restored byte-for-byte from a290f76. wifi_secrets.h stays
    gitignored and was never committed.
    Claude-Session: https://claude.ai/code/session_01EJw78R1NBKwa3rLTwbGv2X
    [esp32_actuator.ino, wifi_secrets.example.h]
2026-09-26 Say why the camera's Wi-Fi isn't joining (firmware v3.1)
    On the rig, v3 booted with pwm=ok and then printed nothing about the
    camera: announceCamera() only spoke once Wi-Fi had an address, so a
    hotspot that refused the board looked the same as a URL that had
    scrolled away.
    The camera task now scans before joining and records whether the hotspot
    was heard (channel and RSSI, or a few names it heard instead), keeps the
    last STA_DISCONNECTED reason, and records the sensor id. loop() reports
    the scan once, "CAM camera ok, sensor 0x…", and while unjoined a
    "CAM wifi not joined: <reason>" line every 10 s. Reasons are matched by
    number so the sketch builds on IDF 4.4 and 5.x. Core 0 still only wr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
2026-09-26 Find the ESP32 camera without the Serial Monitor: camera_probe --find
    Reading the stream URL off COM3 kept failing on the rig: the CAM line
    prints once, near boot, and 10 Hz ST frames bury it. The hotspot also
    hands out a new address most sessions, so the config goes stale.
    `python -m tools.camera_probe --config config/fallback.yaml --find` asks
    for killswitch-cam.local (the firmware's mDNS name), then scans every
    /24 this laptop sits on. It asks each open port 80 for /stream and hangs
    up after the headers, which frees the firmware's single viewer slot. A
    host counts only when it answers multipart with the firmware's own
    boundary, "killswitchframe", so a router or another MJPEG server is
    li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
    [camera_probe.py, test_camera_probe.py]
2026-09-26 Complete a bare camera address to http://<ip>/stream
    On the rig, main.py failed at startup with "No frames from camera stream
    10.244.153.41". The config held the bare address. FFmpeg took it as a
    file path, which reads exactly like a dead camera.
    normalize_stream_url() adds a missing http:// and a missing path, and
    leaves anything with its own path, port or scheme alone.
    HttpStreamSource applies it and logs a warning when it changed the
    value, so main.py, vision_probe and camera_probe all benefit.
    `camera_probe --find` now tries the address already in the config
    before mDNS and the scan. `--write` then stores the full URL. When
    nothing is found, it says the scan covered only this laptop's /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
    [camera_probe.py, test_camera_probe.py, test_stream_source.py]
2026-09-26 Keep reconnecting after the camera is declared lost; restore the example header
    On the rig, the stream stalled for 2 s on venue Wi-Fi at 11:57. The
    reconnect timed out and HttpStreamSource declared the camera lost, which
    was correct. But it also ended its reader thread: _running was both the
    stop flag and the health flag. Nothing reopened the stream for the
    twelve minutes until Ctrl+C. An IDLE node skips the liveness check, so it
    looked alive, and every later cue would have gone SCAN -> camera lost ->
    IDLE until someone restarted window B.
    A separate _healthy event now carries health. Past the reconnect window
    the source reports unhealthy once, so the node still drops to IDLE and the
    effect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
    [test_stream_source.py, wifi_secrets.example.h]
2026-09-26 Stop a silent camera from wedging the stream server (firmware v3.2)
    At 12:16 main.py could not open the stream at all: a 5 s timeout, with
    the ESP32 up for 43 minutes and answering on serial. streamHandler
    retried esp_camera_fb_get() forever when the sensor gave nothing. It
    sends nothing while it waits, so it never learns the viewer has left,
    and it holds the HTTP server's only task. One sensor stall at 11:57 was
    enough to hang every later viewer until a reset.
    After STREAM_STALL_MS (3 s) without a frame the handler now restarts the
    camera (esp_camera_deinit, then startCamera) and returns ESP_FAIL, which
    closes that viewer. The host reconnects to a working camera, and since
    148207c it recov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
    [camera_probe.py, esp32_actuator.ino, test_stream_source.py]
2026-09-26 The bridge opens the live dashboard in Chrome itself
    Bringing the dashboard up failed twice on the rig. Opening
    127.0.0.1:8765 hit the WebSocket feed ("You cannot access a WebSocket
    server directly with a browser"). The http.server for the page had been
    started inside config\, so it served a folder with no page and returned
    404.
    No page server is needed. c2_dashboard.html builds its feed URL from
    location.hostname with a "localhost" fallback, and a file:// page has
    no hostname, so it connects to the local bridge. Once its WebSocket is
    listening, the bridge opens DASHBOARD_PAGE, a path taken from the
    bridge's own file so the current folder no longer matters. It uses
    Chrome when installed (PA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
    [c2_bridge.py, test_cot.py]
2026-09-26 SCAN moves, stops and looks, instead of sweeping every tick
    On the rig the gimbal looked like it never stopped scanning. It
    didn't. _tick_scan called SweepController.step() on every tick, and at
    tick_hz 100 with 4 deg steps that commanded 400 deg/s: faster than an
    SG90 slews, and far faster than a Wi-Fi camera (100-200 ms behind) and
    the detector can look. The frames were smear, so the scan rarely
    locked.
    A search stop now ends only when scan.looks_per_stop (2) frames have
    come back from the detector with no target. Each one must have been
    captured at least scan.settle_s (0.5 s) after the move and have a new
    frame_id. This is the rule the control law already follows (rule 11):
    step only on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
    [bench.yaml, fallback.yaml, smoketest.yaml, test_state_machine.py]
2026-09-26 Say who holds the port when Windows answers "Access is denied"
    serial_probe on the rig failed with "Could not open COM3: ...
    PermissionError(13, 'Access is denied.')". That reads like a
    permissions problem. On Windows it means another program already has
    the port: main.py in window B, a leftover python, or the Arduino
    Serial Monitor.
    port_open_error() keeps the original text. For "Access is denied",
    PermissionError, or Linux's "Device or resource busy", it adds what to
    close, and the PowerShell line that stops leftover python processes.
    A missing port gets no hint. Only the open path changed: no protocol,
    arming or effector code. Two tests; 331 pass. The Stage Sheet's
    recovery row now lists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
    [actuator.py, test_actuator.py]
2026-09-26 Record where the laser gets power; make serial_probe say "watch the laser"
    On the rig, the KY-008 was wired S -> 2N2222 collector and - -> GND. No
    supply reaches the diode in that wiring: when the transistor conducts,
    S is pulled to ~0.2 V and - is already at 0 V. The laser can never
    light. serial_probe still scored 13/13, because every effector check
    reads the firmware's status frames, not light.
    The repo never said where S gets power. It now does, in the firmware
    header (comment only: both builds are byte-identical in size to v3.2),
    in the README wiring table and in CLAUDE.md's hardware table:
    KY-008 S -> the board's 5V pin, - -> collector, middle pin unconnected.
    The README power note no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
2026-09-26 serial_probe --interactive: one-line error when the port won't open
    On the rig, `serial_probe --interactive` with COM3 still held by
    main.py dumped a 30-line traceback. The useful sentence ("Another
    program has COM3 open ...") was on its last line. interactive() only
    caught errors inside its command loop, so a failure in connect()
    escaped. It now prints "ACTUATOR ERROR: ..." and returns 1, as
    run_checks already does. One test; 332 pass.
    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
    [serial_probe.py, test_actuator.py]
2026-09-26 Mirror the pan servo so the gimbal turns the way the radar says (v3.3)
    On the rig the pan SG90 turns anticlockwise, seen from above, as its
    angle rises. Everything upstream assumes clockwise: cue_to_gimbal maps
    azimuth 315 (north-west) to pan 45, and the dashboard radar and the
    control law use the same sense. So a threat on the radar's left swung
    the gimbal to the right.
    Every pan write in the firmware now goes through writePan(): the slew
    update, setup()'s stow, and the raw T sweep. It clamps, then sends
    (PAN_MIN + PAN_MAX) - angle when PAN_REVERSED. The limits are symmetric
    about 90, so the mirrored angle stays in bounds, and stow (90) is
    unchanged. Every angle above the PWM write keeps i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
2026-09-26 Revert "Mirror the pan servo so the gimbal turns the way the radar says (v3.3)"
    This reverts commit 10bd411.
    The rig's operator doesn't want to reflash the board. The pan reversal
    moves to the laptop side instead (next commit), so firmware stays v3.2
    and every angle on the wire keeps the servo's own sense.
    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
    [esp32_actuator.ino]
2026-09-26 Reverse the pan servo on the laptop side: actuator.pan_reversed
    The rig's pan SG90 turns anticlockwise, seen from above, as its angle
    rises. Everything upstream means clockwise: cue_to_gimbal (azimuth 315
    -> pan 45), the dashboard radar, and the control law. So a threat on
    the radar's left swung the gimbal right. The operator doesn't want to
    reflash, so the fix lives in SerialActuator, where every angle crosses
    the wire:
    - set_angles clamps as before, then sends mirror_pan(pan)
    (PAN_MIN + PAN_MAX - pan) when pan_reversed.
    - Every ST frame's pan is mirrored back before anyone sees it: node
    telemetry, the dashboard, serial_probe's checks.
    The limits are symmetric about 90, so the clamp-t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
    [actuator.py, bench.yaml, fallback.yaml, serial_probe.py, test_actuator.py]
2026-09-26 Add a one-command preflight for live runs, and a boresight reticle
    python -m tools.preflight --config <cfg> checks what every failed run so
    far tripped on, in the order the stack needs it: weights on disk (offline
    box), broker up, COM3 free, the firmware's boot line, the camera address
    the firmware reports against camera.stream_url, the one-viewer stream,
    and ~6 s of detection on the live target. One PASS/WARN/FAIL row per
    check with its fix; non-zero exit on any FAIL; READY prints the start
    order for that config.
    This board does not reset when COM3 opens (earlier runs connected at
    up=679793ms, 2567093ms, 13314693ms), so its boot line, the only place the
    firmware states its version and pwm=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
    [preflight.py, test_preflight.py, vision_probe.py]
2026-09-27 pushing product and prototype video
2026-09-27 Record the hackathon submission and bring the docs up to date
    README gets a Submission section: the pitch deck, the product video and
    the prototype demo video, where each lives in the repo, what each shows,
    and the team. The prototype video's filename keeps its submitted spelling.
    The hardware verification log now states the rig as submitted on firmware
    v3.5: what is verified (preflight, camera, quiet servo sweep at 20-160,
    live node with PHYSICAL GIMBAL on the dashboard) and what is not (13/13 on
    v3.x, a YOLO lock on the rig, SPACE -> ENGAGE on the rig).
    CLAUDE.md records the submission, the same verification status, the
    USB CDC On Boot trap that silenced COM3, and the v3.5 Wi-Fi watchdog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
